NRGN2ART/Network-IV/Rebooted/Photos/NW4RebootedPair.jpg

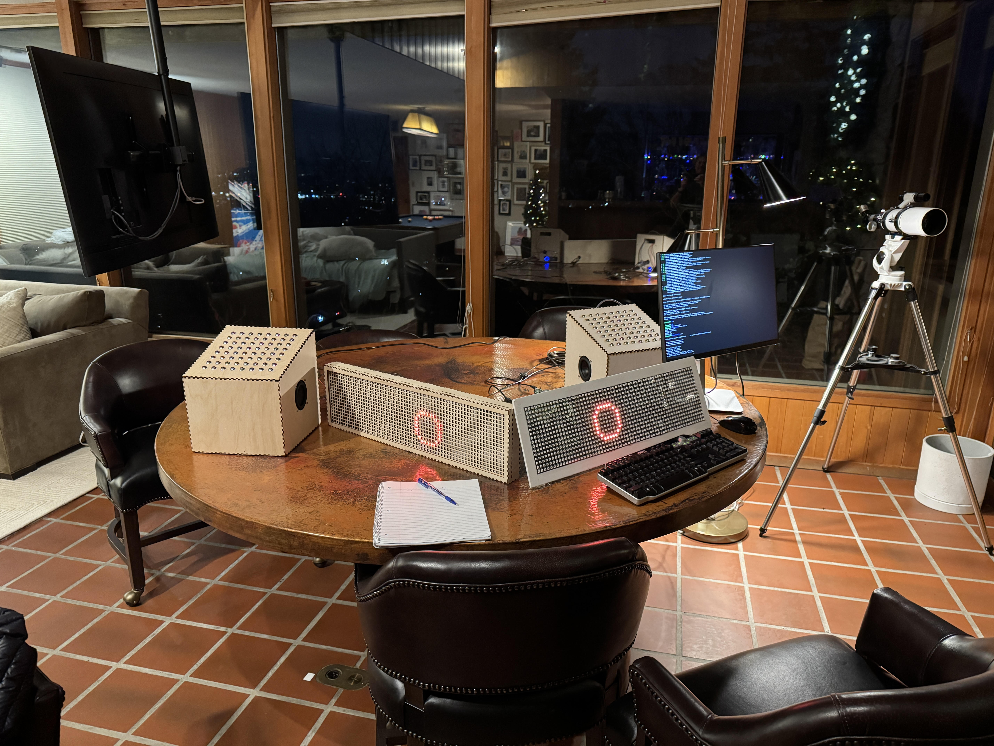
Rebooted/Photos/NW4RebootedPair.jpg
