NRGN2ART/Network-IV/Rebooted/Photos/NW4ButtonDetail.jpg

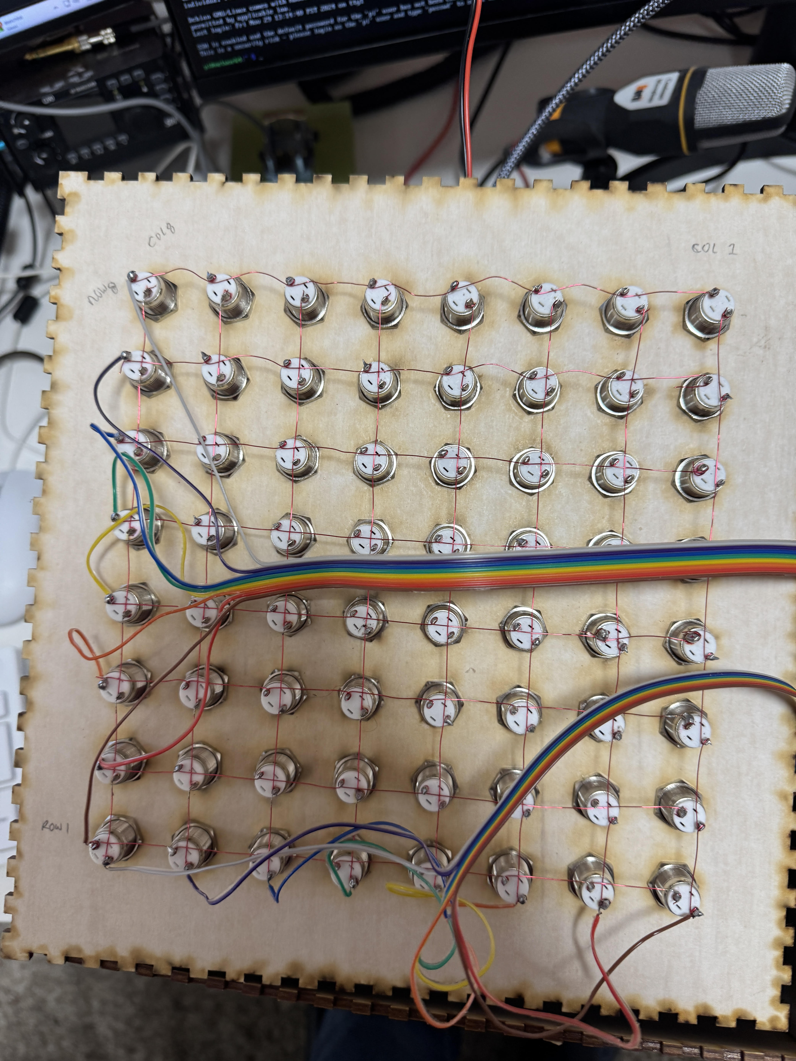
Rebooted/Photos/NW4ButtonDetail.jpg
