NRGN2ART/Network-IV/README.md

# Network-IV

1) Documentation of James Seawright's Network IV

2) Reboot of Network IV by Andrew Seawright under the "Rebooted" folder
   
Key Directories
---------------

Documentation -> original Network IV engineering documents

Code -> Original Network IV code - listing and paper tape data

Rebooted -> the reboot of Network IV on a small scale via emulation of the original code

Other pointers to Network IV and James Seawright:
* https://www.seawright.net/sculpture/opus20
* https://www.seawright.net/network-iv-rebooted
* https://www.seawright.net/network24
* https://www.seawright.net/
