NRGN2ART/Network-IV/Rebooted/README.md

This directory contains the Network IV reboot code and documentation

* The Teensy folder contains the Teensy 4.0 code for the sound and display processors
* The LaserCut folder contains files to build the enclosures
* The simh folder describes the changes to simh Nova emulator to direct IO device 76 to the Teensy devices
* The Photos folder has some pictures of the project
* Runtime holds setup scripts and runtime data used by Network IV / SIMH
* Utility are some runtime utilities to talk and test to the Teensy's interfaces from the Raspberry Pi

Videos of Network IV rebooted
* https://www.youtube.com/watch?v=DnSIwxefAp8
* https://www.youtube.com/watch?v=5fbXEzOQV64
