NRGN2ART/Network-IV/Rebooted/LaserCut/README.txt

This directory contains laser cutting files for Network IV emulators

3mm Baltic Birch Plywood

First version of the pedestal unit:

  ConsolePage1.svg
  ConsolePage2.svg
  ConstolPage3.svg

Box with volume ~ 0.08 cubic ft:

  SpeakerPage.svg

Display unit:

  Matrix1.svg
  Matrix2.svg 

These files are created with respect to these instructions: https://www.digitalcraftpdx.com/file-prep/

Notes:

  The console was generaed using this online generator and then adding elements (holes for buttons, speakers, etc.): 
       https://boxes.hackerspace-bamberg.de/Console?language=en

  The display "matrix" was was generated using this online generator with some manual edits to fix bugs in the generator in handling 16x64 leds: 
       https://boxes.hackerspace-bamberg.de/Matrix?language=en
