NRGN2ART/Network-IV/Rebooted/Teensy/README.txt

This directory contains versions of the Network IV simulation Teensy processors
