NRGN2ART/Network-IV/Rebooted/Utility/README.md

Utility programs to control sound/input and display Teensy devices

Makefile
sound.c
display.c
