NRGN2ART/Network-IV/Rebooted/Runtime/README.md

These are runtime files used by the simh/nova emulator for Network IV Rebooted

setup.sh   :  source to setup before running nova
nova.ini   :  initial setup sourced by nova for Network IV Rebooted
gamelan.do :  pitch list from Charlie Keagle with known value to pitch assignments (Sound teensy calibrated to these values)

clear.sh   :  mute sound and clear display
norow.sh   :  modify display mode in order to run display test
