NRGN2ART/Network-IV/Network IV Talk.pdf

# Network IV

SEA-TAC Airport Sound-Light Environment

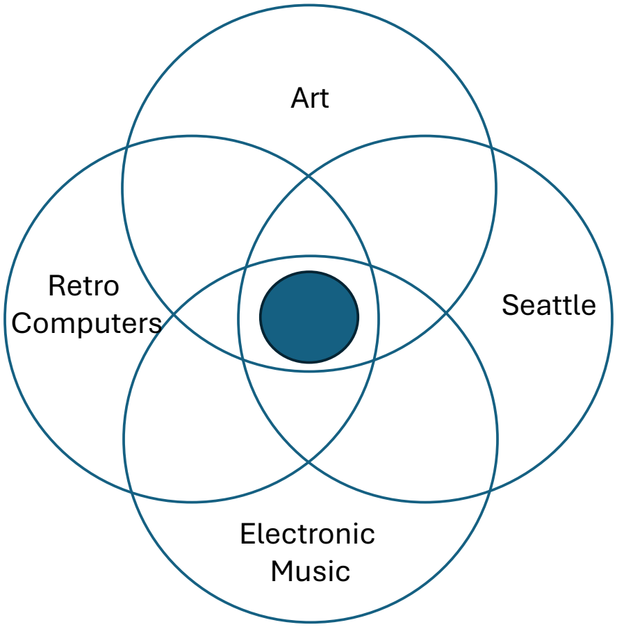
[picture p3: figure]
Retro; Computers; Seattle; Electronic Music; Art

## Outline

- James Seawright’s Network IV SEA-TAC installation
- Rebooting Network IV

## James Seawright 1936 - 2022

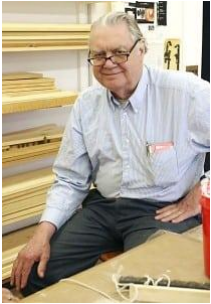
[picture p4: figure]

- Technological Artist / Kinetic Sculptor
- Director of Visual Arts Princeton University
- Technical Supervisor Columbia-Princeton Electronic Music Center

## James Seawright Network Series

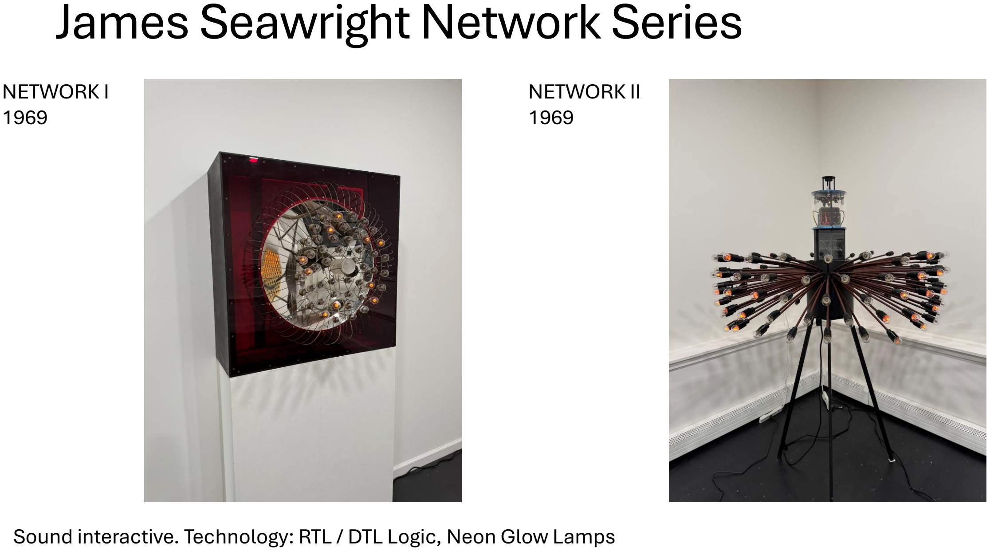
[picture p5: page 5]

NETWORK I
1969

NETWORK II
1969

Sound interactive. Technology: RTL / DTL Logic, Neon Glow Lamps

## Network III 1971

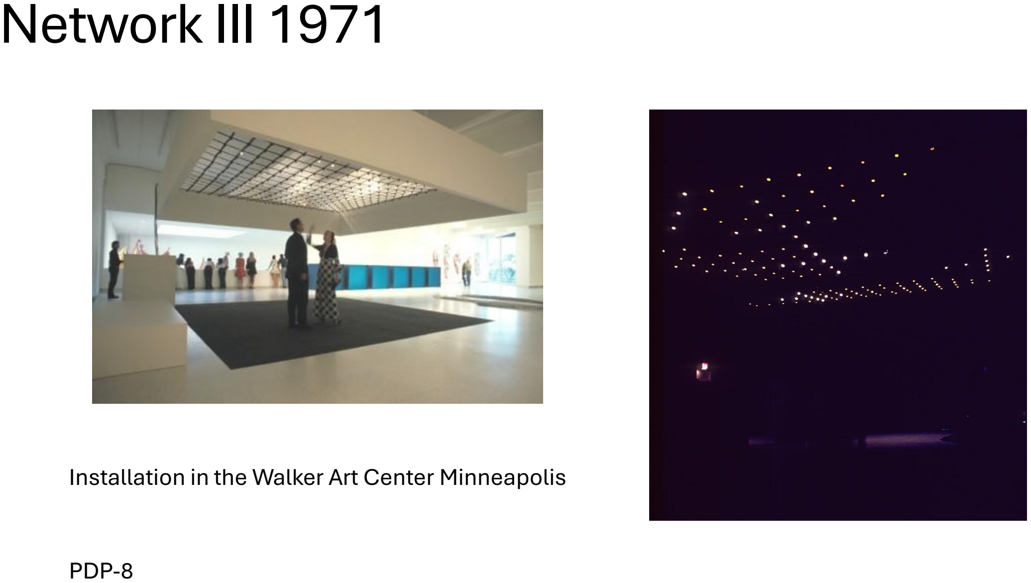
[picture p6: page 6]

Installation in the Walker Art Center Minneapolis

PDP-8

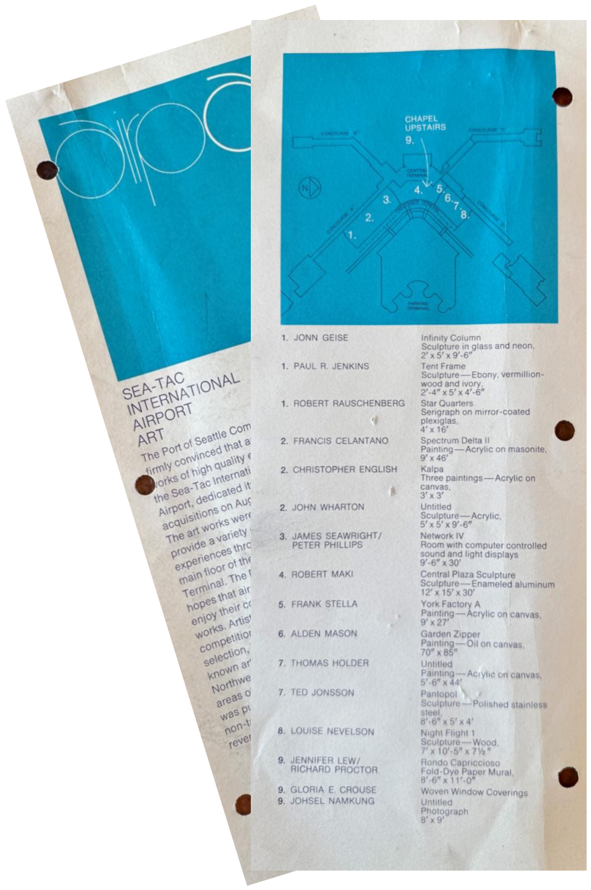
[picture p7: figure]

## SEA-TAC ART

1973

“The Port of Seattle
Commission, firmly
convinced that artistic works of high quality enhance the Sea-Tac International Airport, dedicated its art acquisitions on August 1, 1973. …”

## Network IV

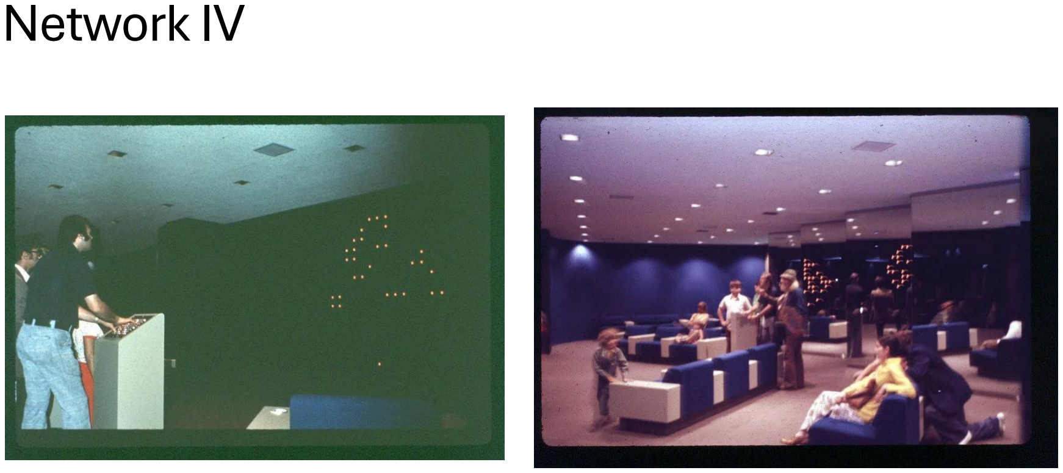
[picture p8: page 8]

## Network IV

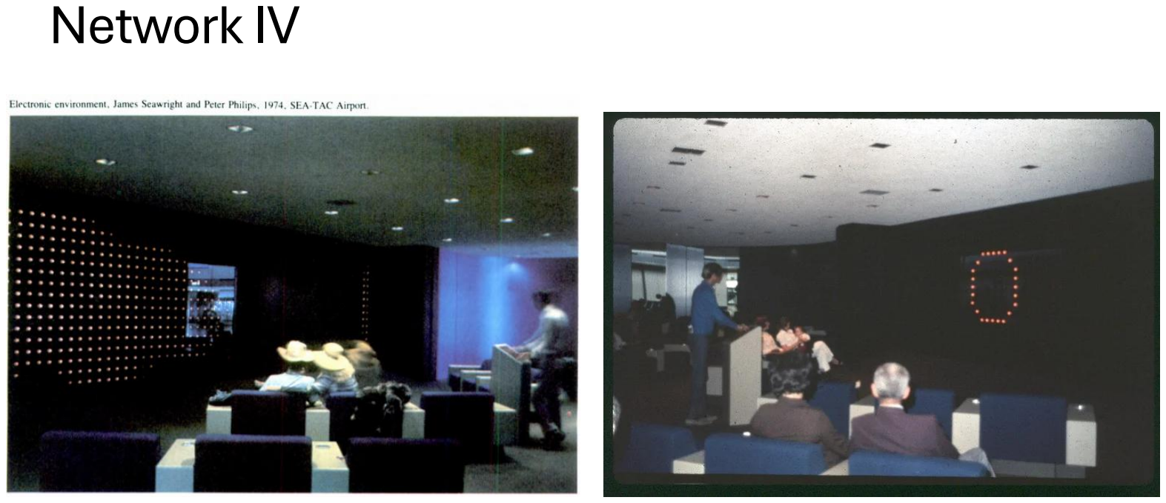
[picture p9: page 9]

## Network IV Behavior

- Idle mode: a blob pattern moves back and forth across the display, seeming to bounce off the top or bottom, and traveling at various rates with a loosely structured sound accompaniment
- Interactive mode: button patterns introduce rapidly changing patterns based on John Conway’s life game appear accompanied by synchronized sound patterns

# Network IV Under the Hood

### Network IV SEA-TAC Airport Sound-Light Environment

- Display Wall
- 64 x 16 Neon glow light array
- 6” centers
- 8ft high by 32ft long behind plate glass
- Touch plate with 8x8 buttons
- Sound
- Three Moog-style electronic synthesizer instruments controlled from DACs
- 32 digitally triggered resonators
- Computer
- Data General Nova 1210
- Data General #4040 “General Purpose Interface”

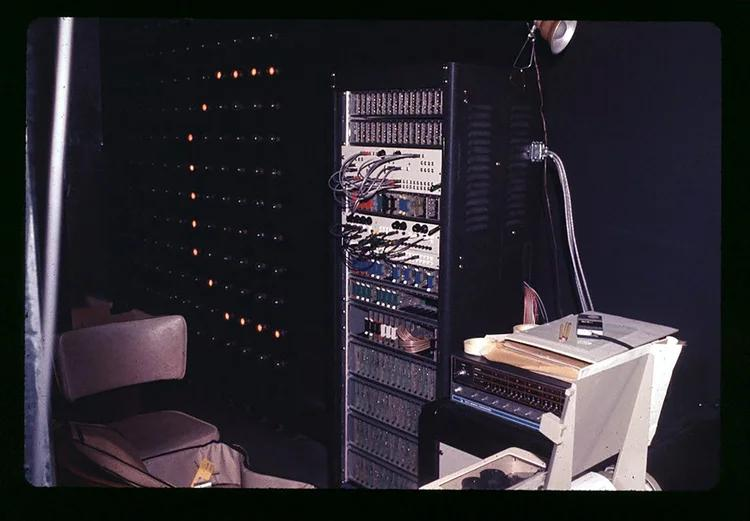
[picture p10: page 13]

## Network IV Sound

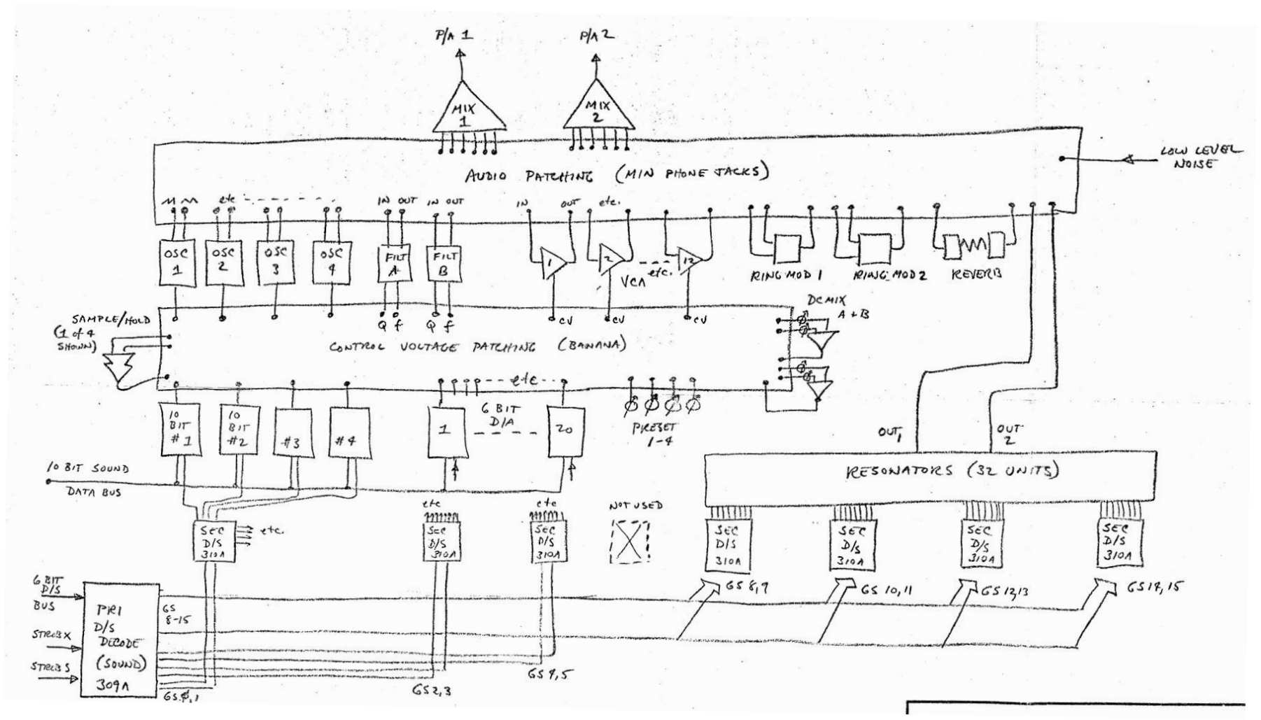
[picture p11: figure]
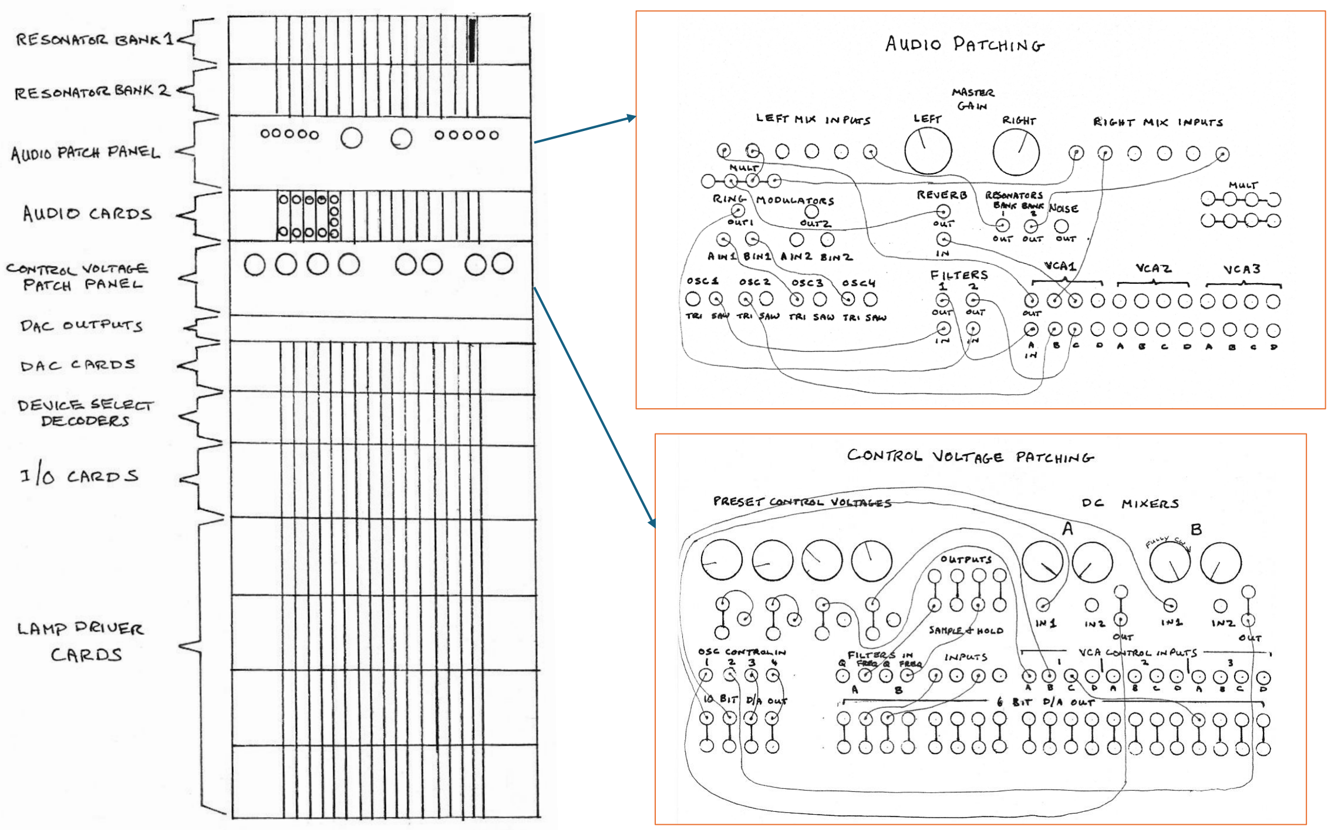
[picture p12: page 15]

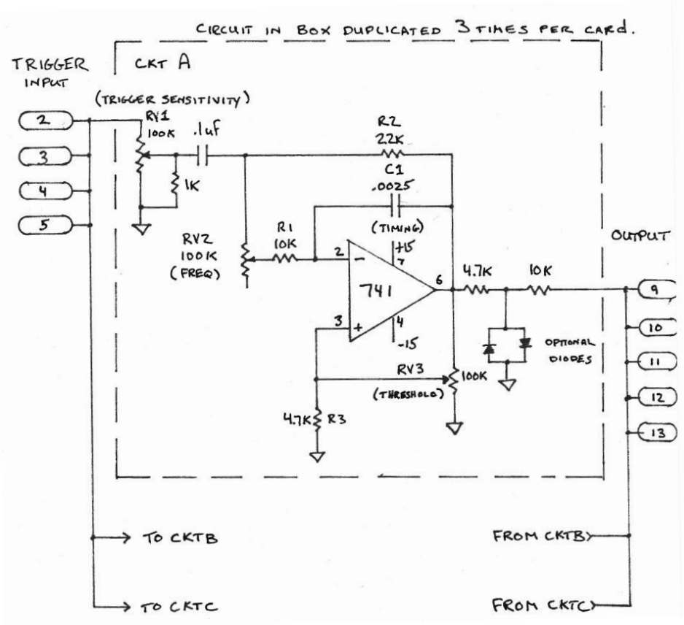
[picture p13: figure]

## Resonators

32 Resonators

Each one is three 741
circuits producing decaying sinusoidal resonant sound

Triggered by the computer

## Program

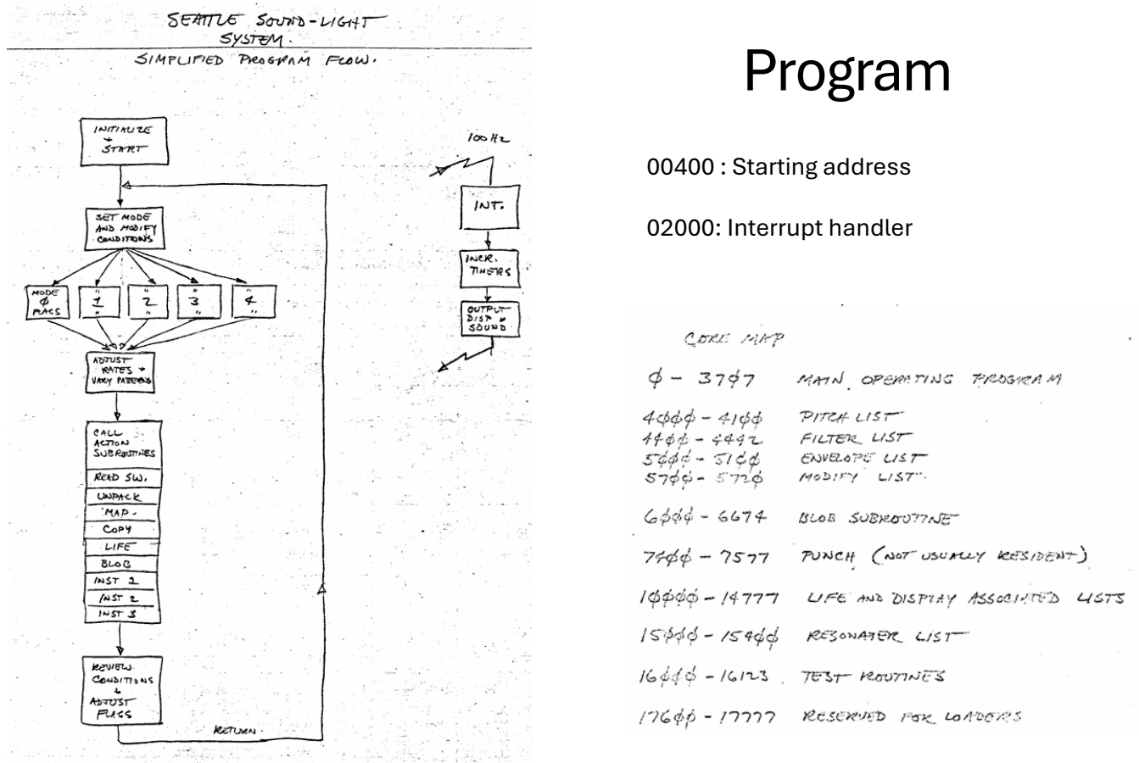
[picture p14: page 17]

00400 : Starting address

02000: Interrupt handler

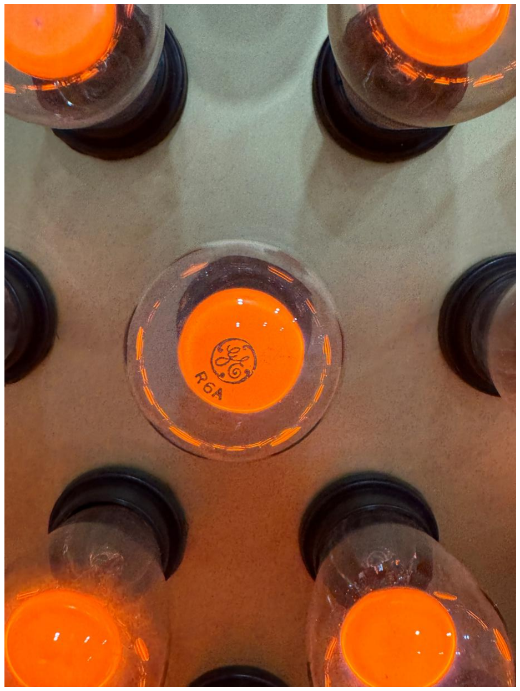
[picture p15: figure]

## Network IV

- Network IV was in operation from 1973 – late 90’s or early 2000’s
- There were overhauls in 1986 and 1988
- The surviving elements
- neon glow lamps
- the code
- documentation

# Network IV Rebooted

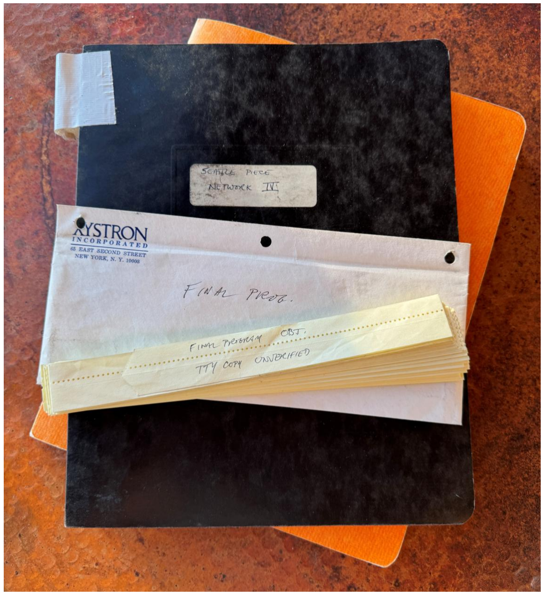
[picture p16: figure]

## Genesis

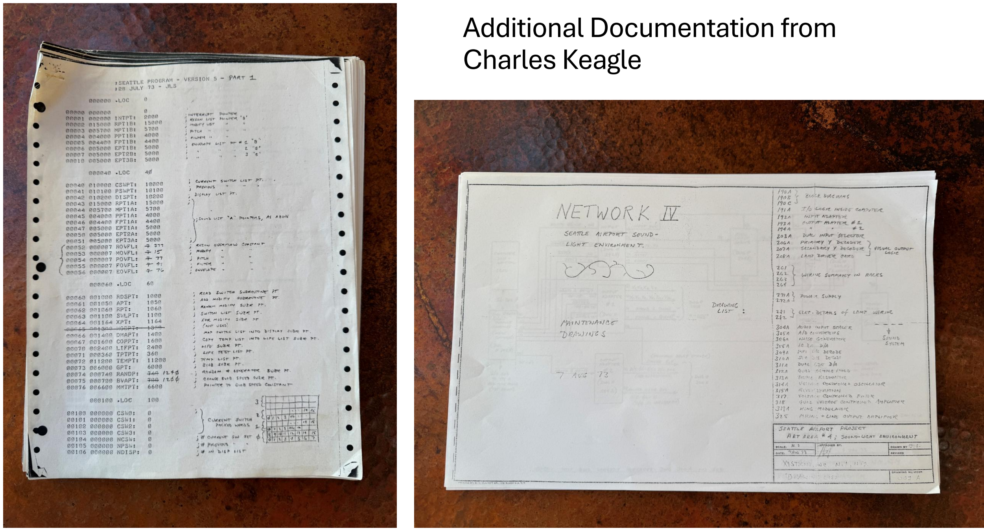
[picture p17: page 21]

Additional Documentation from Charles Keagle

## Project threads

- How to convert the paper tape ?
- Understand SIMH NOVA
- IO mapping and timer interrupt ?
- Sound modeling
- Display and input

## Paper Tape Conversion Saga

- Built and tried a couple open-source DIY “hand pulled” AVR based readers
- Not reliable enough
- Purchased REMEX RRS7155BA1 reader on ebay
- Inspired by Robert Baruch (https://www.youtube.com/@RobertBaruch) https://www.youtube.com/watch?v=dq2EuooRrVc
- REMEX reader had power supply issue
- Backup plan – started hand entering from assembled listing (~30% completed)
- REMEX working ☺ Bypass REMEX power supply with bench supplies, fixed bad filter cap later
- Adruino UNO to control REMEX and output data as HEX to laptop
- Video: https://www.youtube.com/shorts/PvraiOrcCRk
- Understand Nova paper tape format
- Python script to convert tape data in Nova format to SIMH deposit commands
- Checksums all match! ☺
- Comparing hand entered code from listing to tape data matched ☺
- Data files, conversion scripts and Arduino code is on github

## Paper tape first attempts

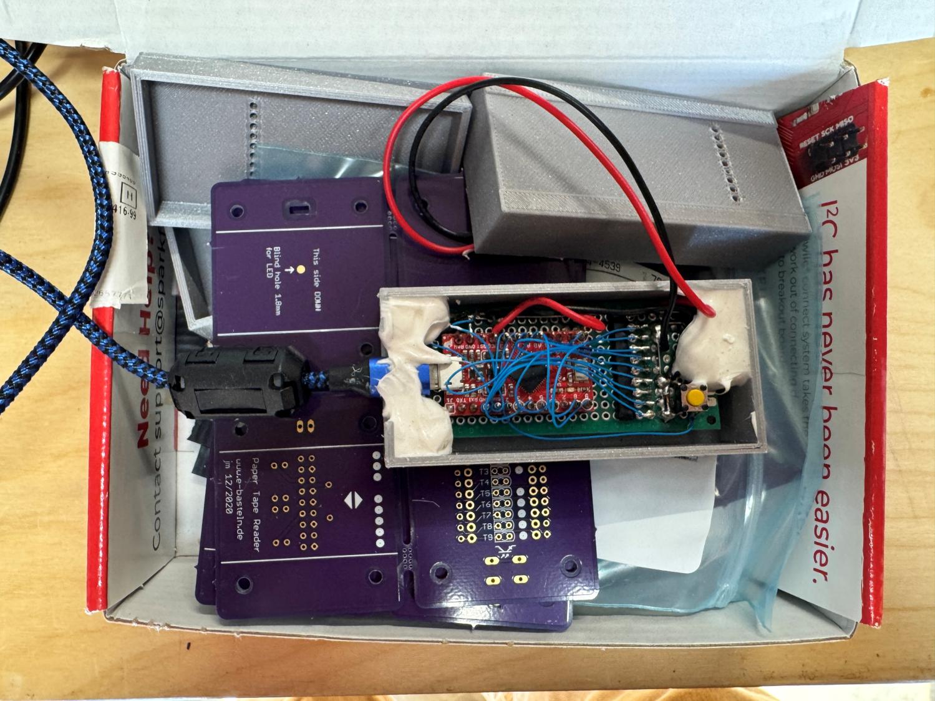
[picture p18: figure]

## Tape Reader Setup: REMEX RRS7155BA1 + Arduino -> Ascii Hex -> Laptop Serial Port

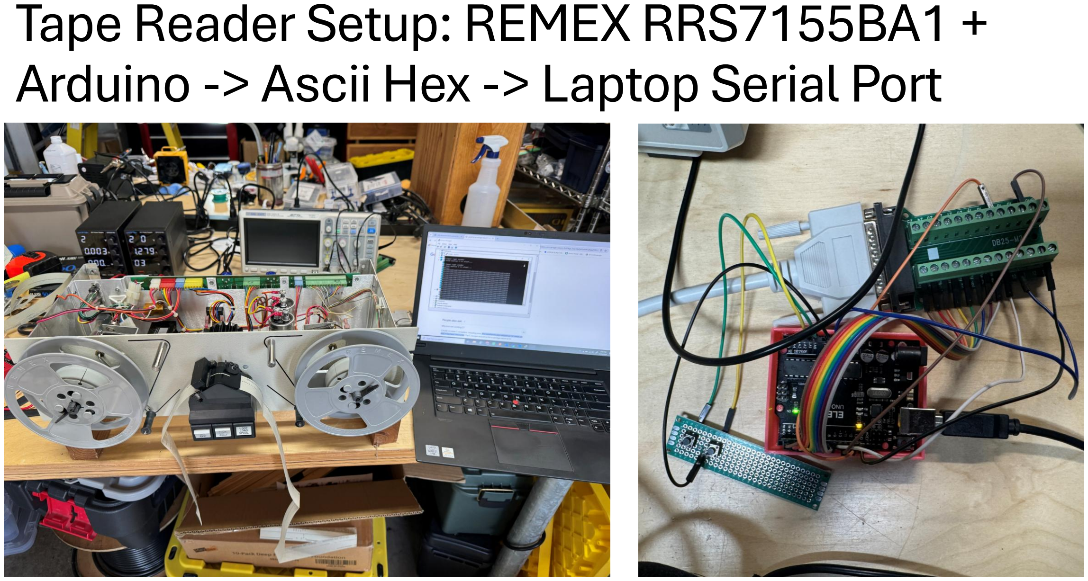
[picture p19: page 25]

## Code emulation

- Using SIMH NOVA -> Started running Network IV code
- Timer interrupts working out of the box!
- Modify SIMH NOVA to handle Device 76 (octal) IO
- Initial print-based debug showed signs of “life”
- Move SIMH to Raspberry Pi
- Redirect to IO to sound/input and display Teensy devices
- The original code is running with no changes from the converted paper tape

## Sound

- Emulate sound using a Teeny 4.0 + DAC PT8211
- 600MHz ARM w floating point
- Compute the analog waveforms digitally
- Started with resonators
- Trio of decaying sinusoids
- 32 resonators
- Added the three instruments
- Oscillators
- VCA
- Ring modulator
- Voltage controlled filters are not modeled yet

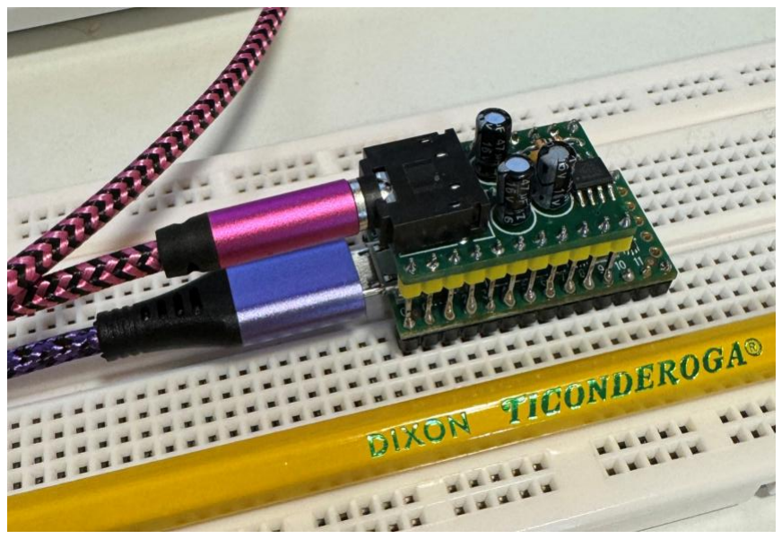
[picture p20: figure]

- Sounds controlled via simple fast serial commands over USB
r 5
s 1 101
- Sound controller also reads button status

## Display

- Use another Teensy for handling the display
- Four 16x16 addressable LED matrix displays
- Control with serial commands
- Clear display (c )
- Light a particular light (l <r> <c>)
- Update a whole row of 64 lights with 16 hex chars (r <r> <hexdata>)

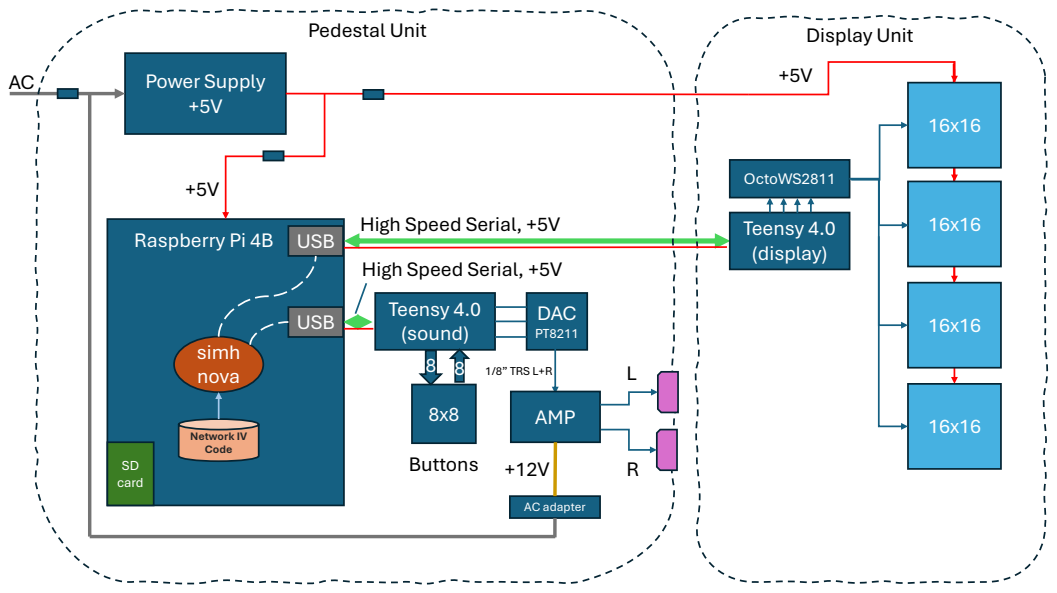
[picture p21: page 29]
Power Supply +5V; simh nova; SD card; Network IV Code; USB; DAC; Teensy 4.0 (display); AMP; OctoWS2811; AC adapter; Raspberry Pi 4B; 1/8” TRS L+R; Buttons; Pedestal Unit; Display Unit

High Speed Serial, +5V
USB
Teensy 4.0
(sound)

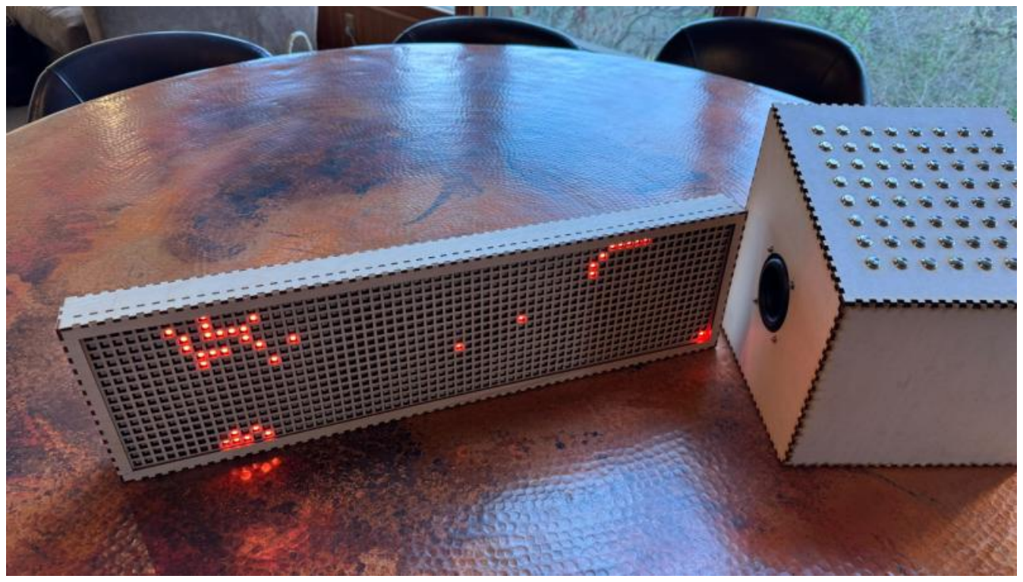
[picture p22: page 30]

## Two Network IV Rebooted!

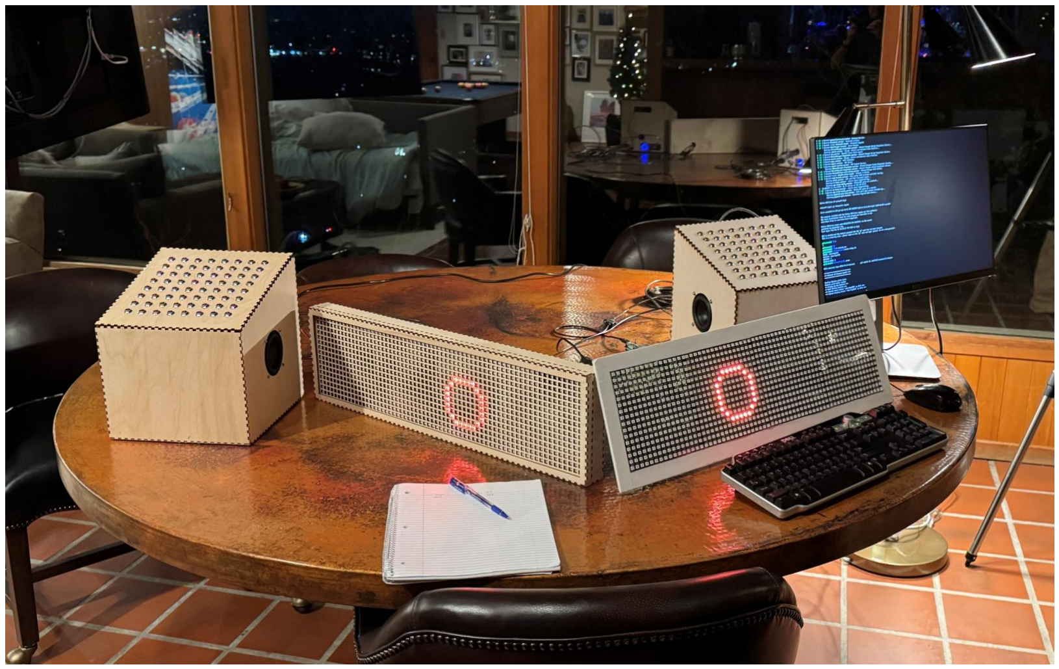
[picture p23: figure]

## Future Directions

- Add MIDI capability
- Add configurability to redirect certain instruments / sound parameters to certain MIDI channels
- Mix Teensy sound emulation with synthesizers including real analog synths
- Larger installation?
- Revive using real a Nova system?

## Acknowledgements

- Charles Keagle
- SIMH Project

## Links

- James Seawright
- https://www.seawright.net/
- Network IV
- https://www.seawright.net/sculpture/opus20
- Network IV rebooted
- https://www.seawright.net/network-iv-rebooted
- GitHub
- https://github.com/NRGN2ART/Network-IV
- https://github.com/NRGN2ART/PaperTapeReader
- Youtube
- (https://www.youtube.com/watch?v=5fbXEzOQV64) Network IV Rebooted (https://www.youtube.com/watch?v=5fbXEzOQV64)

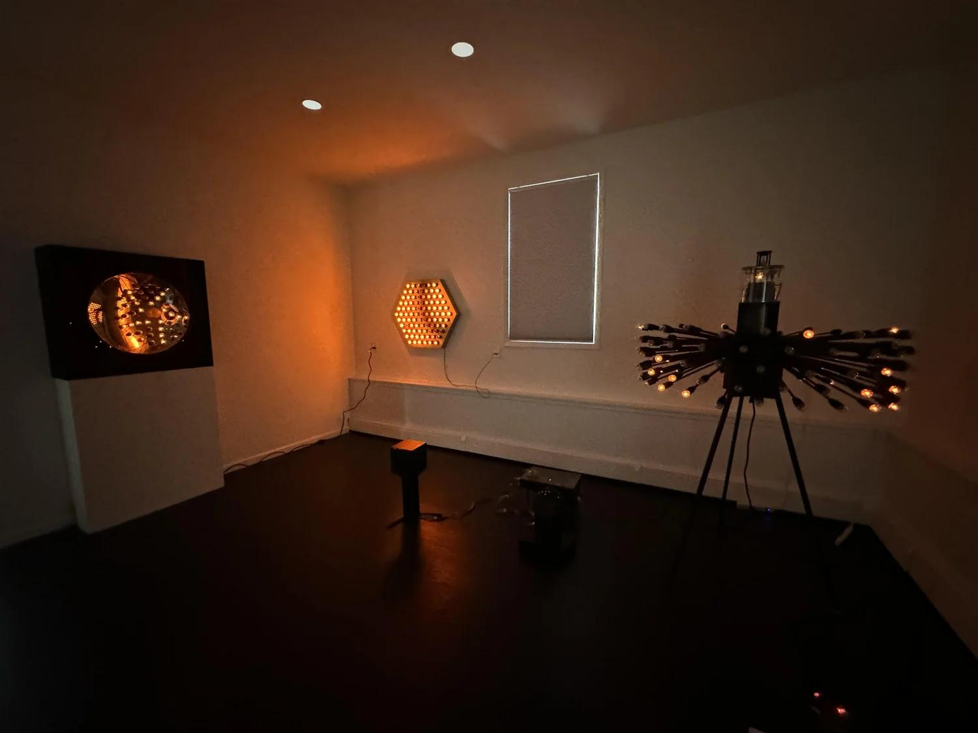
[picture p24: page 35]
