NRGN2ART/Network-IV/Documentation/SEA-TAC_ART_NetworkIV.jpg

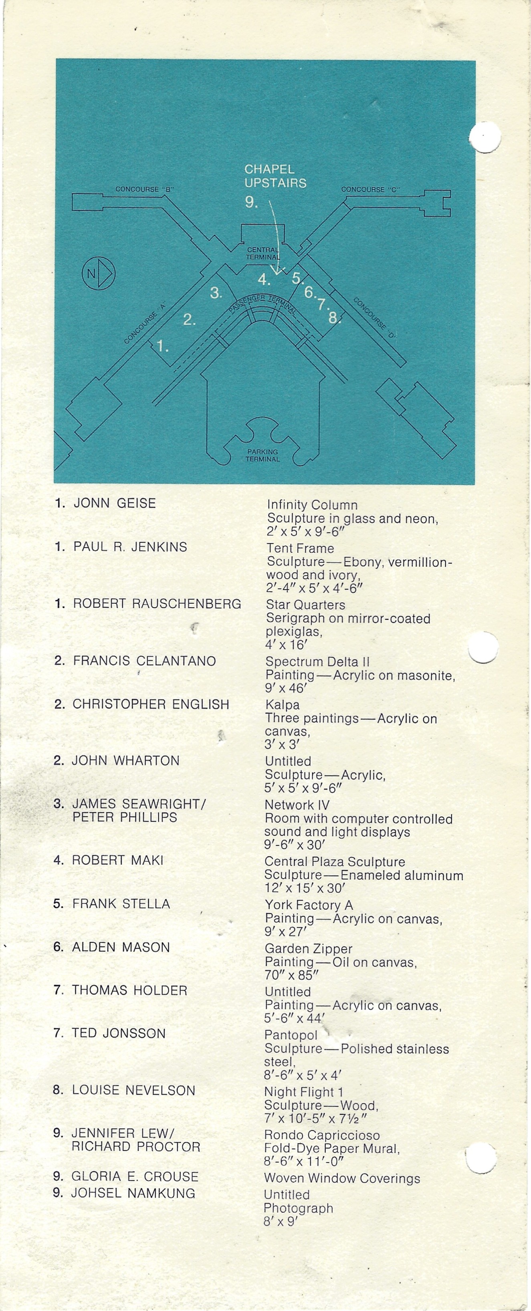
Documentation/SEA-TAC_ART_NetworkIV.jpg
