NRGN2ART/Network-IV/Photos/network 4.jpg

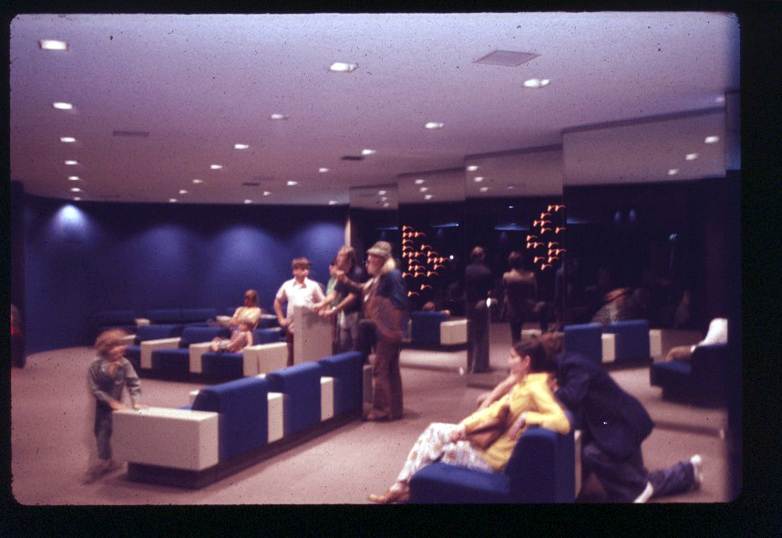
Photos/network 4.jpg
