NRGN2ART/Network-IV/Photos/Network_IV.png

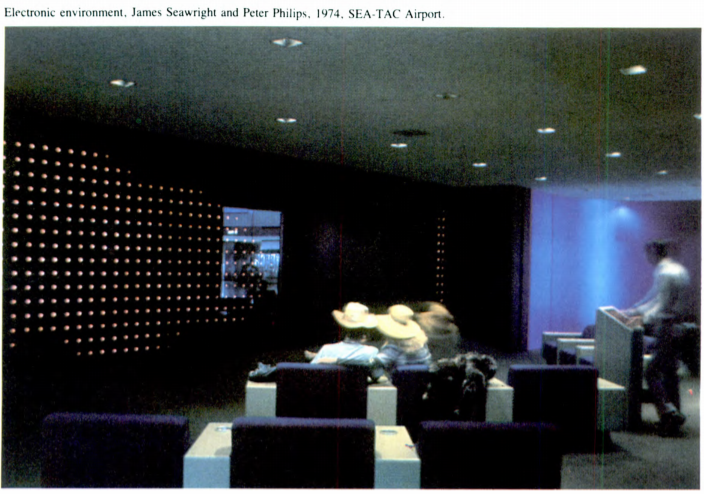
Photos/Network_IV.png
