NRGN2ART/Network-IV/Photos/Transparency0002.JPG

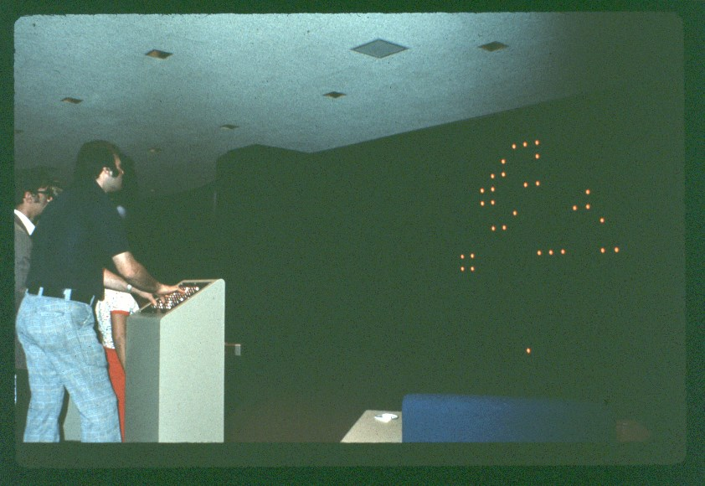
Photos/Transparency0002.JPG
