NRGN2ART/Network-IV/Photos/Transparency0003.JPG

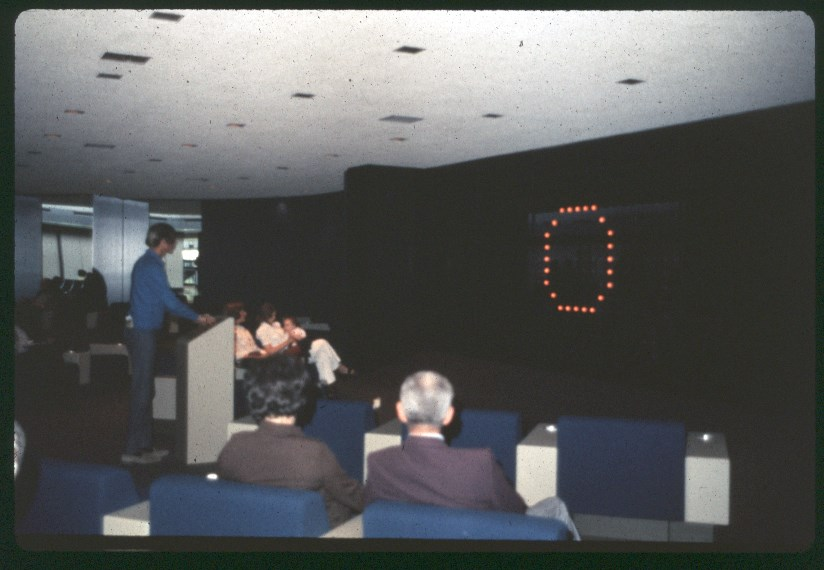
Photos/Transparency0003.JPG
