NRGN2ART/Network-IV/Rebooted/NetworkIV Reprised.png

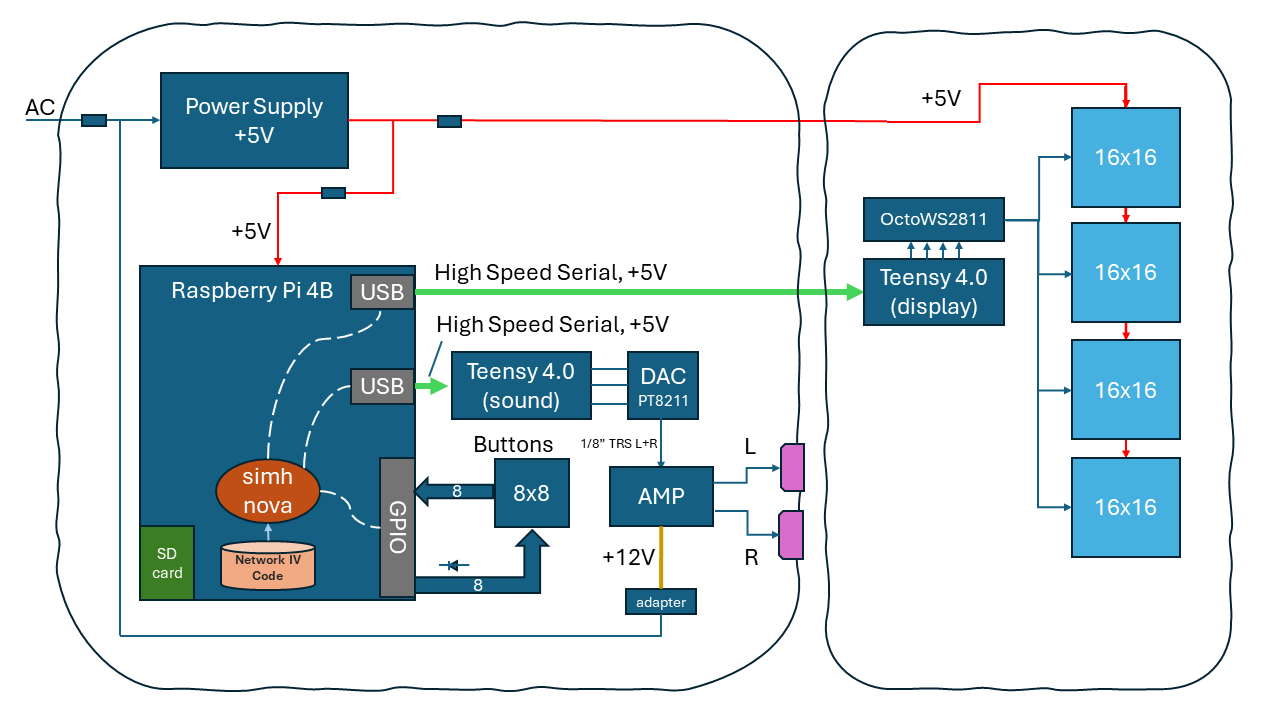
Rebooted/NetworkIV Reprised.png
