NRGN2ART/Network-IV/Rebooted/Photos/NetworkIVprotoconnections.jpg

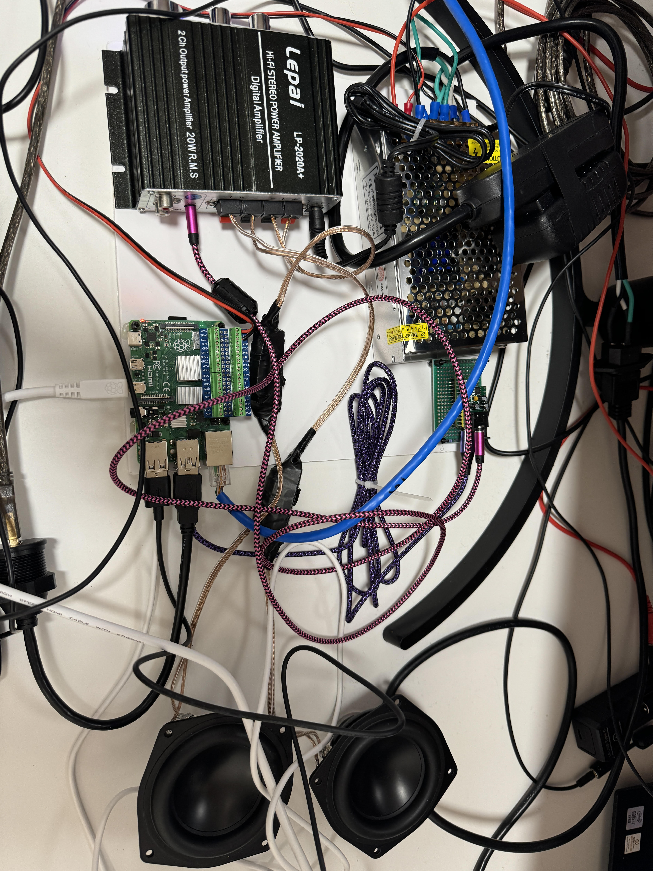
Rebooted/Photos/NetworkIVprotoconnections.jpg
