NRGN2ART/Network-IV/Rebooted/Photos/NetworkIVprotodisplay.jpg

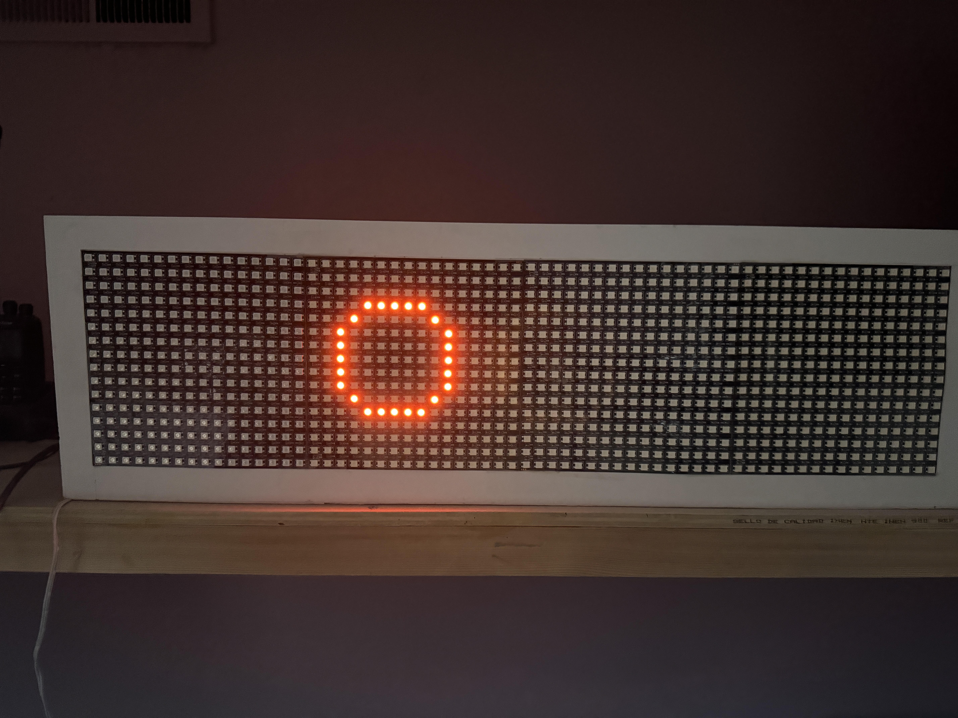
Rebooted/Photos/NetworkIVprotodisplay.jpg
