NRGN2ART/Network-IV/Rebooted/Photos/NW4Blob.jpg

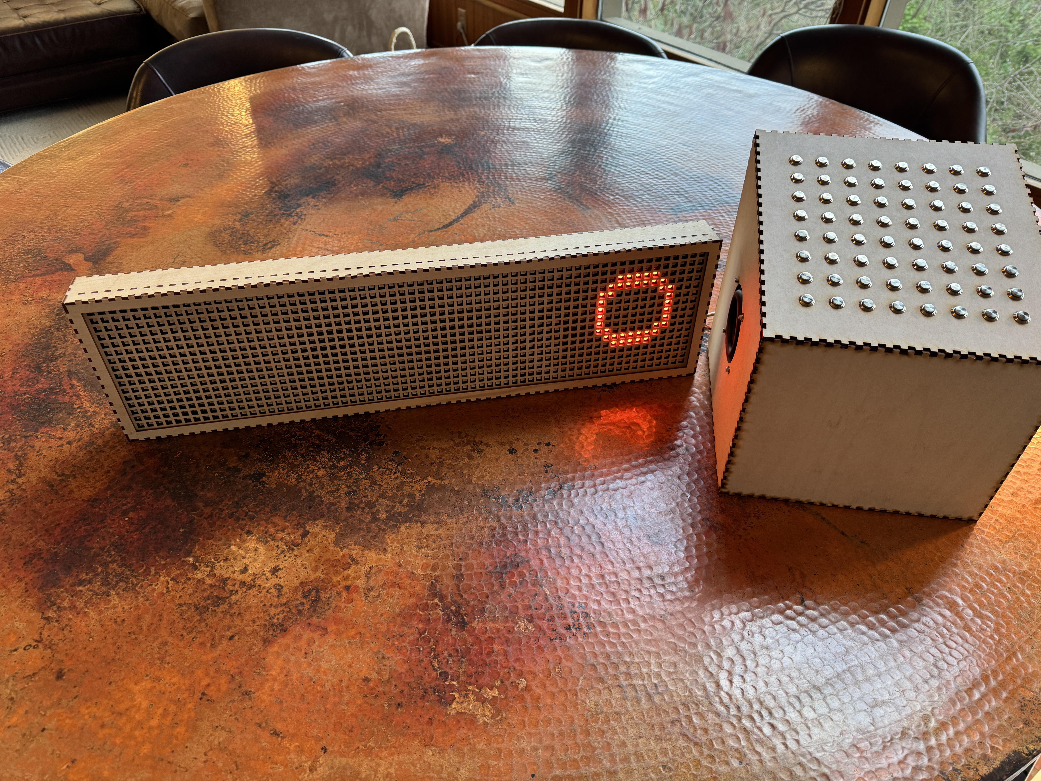
Rebooted/Photos/NW4Blob.jpg
