NRGN2ART/Network-IV/Rebooted/Photos/NW4ConsoleAndDisplay.jpg

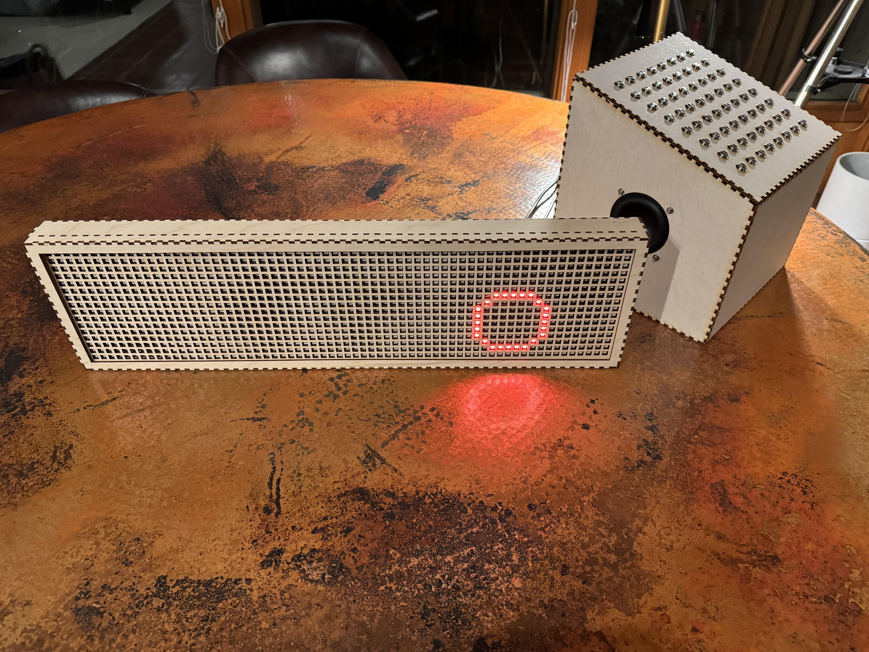
Rebooted/Photos/NW4ConsoleAndDisplay.jpg
