NRGN2ART/Network-IV/Rebooted/Photos/NW4InsideConsole.jpg

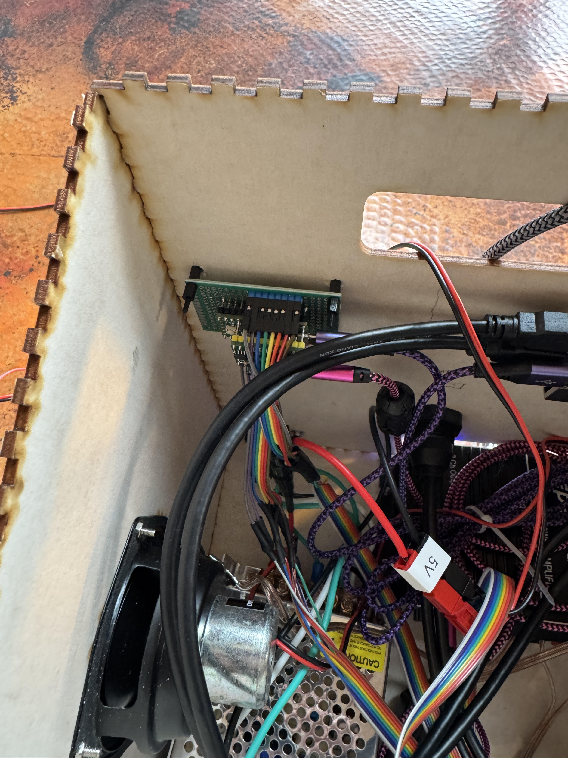
Rebooted/Photos/NW4InsideConsole.jpg
