NRGN2ART/Network-IV/Rebooted/Photos/NW4Rebooted2.jpg

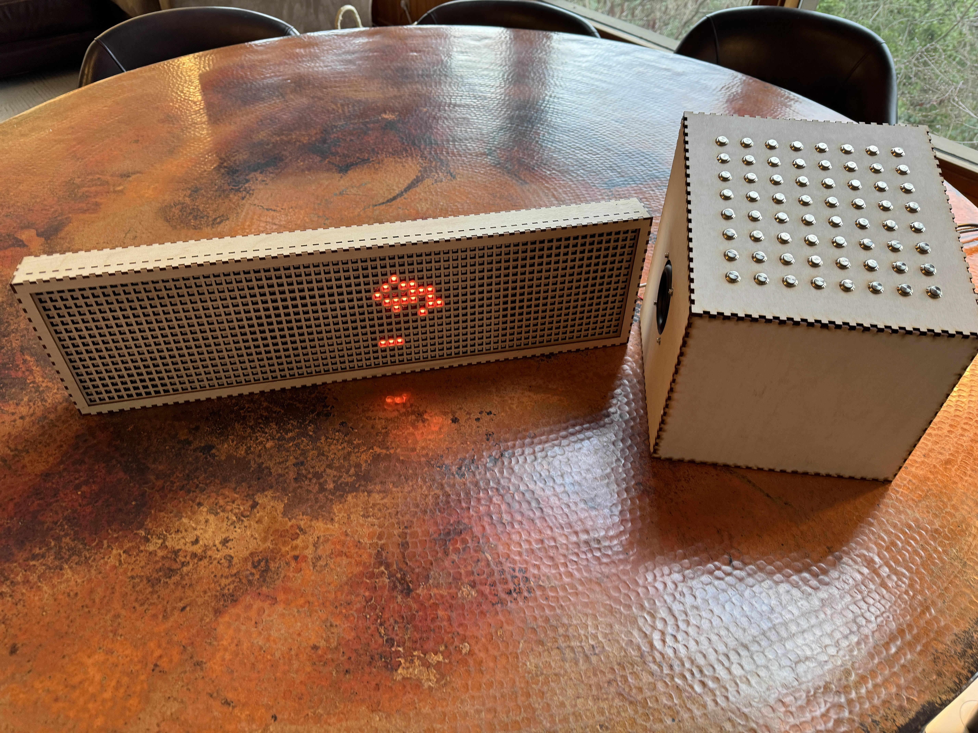
Rebooted/Photos/NW4Rebooted2.jpg
