NRGN2ART/Network-IV/(commit log)

2025-01-11 Add files via upload
    Fix button layout to match real NW4
    [sketch_network_iv_sound_v6.ino]
2025-05-02 Rename LaserCut/ConsolePage1.svg to Rebooted/LaserCut/LaserCutConsolePage1.svg
    move
2025-05-02 Rename LaserCut/ConsolePage2.svg to LaserCutRebooted/LaserCut/ConsolePage2.svg
    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
2025-05-02 Rename LaserCutRebooted/LaserCut/ConsolePage2.svg to Rebooted/LaserCutRebootedLaserCutConsolePage2.svg
    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
2025-05-02 Rename ConsolePage3.svg to LaserCutConsolePage3.svg
    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
2025-05-02 Rename LaserCut/Matrix1.svg to Rebooted/LaserCut/LaserCutMatrix1.svg
    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
2025-05-02 Rename LaserCut/Matrix2.svg to Rebooted/LaserCut/LaserCutMatrix2.svg
    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
2025-05-02 Rename LaserCut/README.txt to Rebooted/LaserCut/LaserCutREADME.txt
    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
2025-05-02 Rename LaserCut/SpeakerPage.svg to Rebooted/LaserCut/LaserCutSpeakerPage.svg
    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
2025-05-02 Rename LaserCutREADME.txt to README.txt
    rename
2025-05-02 Rename LaserCutConsolePage1.svg to ConsolePage1.svg
    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
2025-05-02 Rename LaserCutMatrix1.svg to Matrix1.svg
    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
2025-05-02 Rename LaserCutMatrix2.svg to Matrix2.svg
    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
2025-05-02 Rename LaserCutSpeakerPage.svg to SpeakerPage.svg
    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
2025-05-02 Rename Rebooted/LaserCutConsolePage3.svg to Rebooted/LaserCut/ConsolePage3.svg
    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
2025-05-02 Rename Rebooted/ConsolePage2.svg to Rebooted/LaserCut/ConsolePage2.svg
    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
2025-05-02 Rename Teensy/README.txt to Rebooted/Teensy/README.txt
    moved
2025-05-02 Rename Teensy/sketch_network_iv_sound_v6.ino to Rebooted/Teensy/sketch_network_iv_sound_v6.ino
    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
    [sketch_network_iv_sound_v6.ino]
